Rayassss/Homework/README.md

## 睿睿的课设

***

### 编译代码

#### 编译ESP8266源码：

+ 在ubuntu系统下进入esp8266程序目录
+ 输入:：sudo chmod +x compile.sh requirements.sh
+ 输入：./requirements.sh 即可安装集成开发环境
+ 安装完成后，输入./compile即可编译

#### 编译STM32源码：
+ 安装keil for arm
+ 安装stm32f1xx.pack
+ 点击“编译”即可

#### 编译串口上位机：
+ 安装visual studio community 2017
+ 安装visual C#依赖
+ 点击“启动”即可编译

#### 编译网络上位机：
+ 安装python3.8.2
+ 安装配套的pip
+ 运行目录下的"build.bat"文件即可

#### 配置服务器端：
+ 将install.sh文件拷贝到服务器上
+ 输入：sudo chmod +x install.sh
+ 输入：./install.sh即可完成安装# Homework
