Rayassss/Homework/3119006261罗启睿的嵌入式课设计报告.md

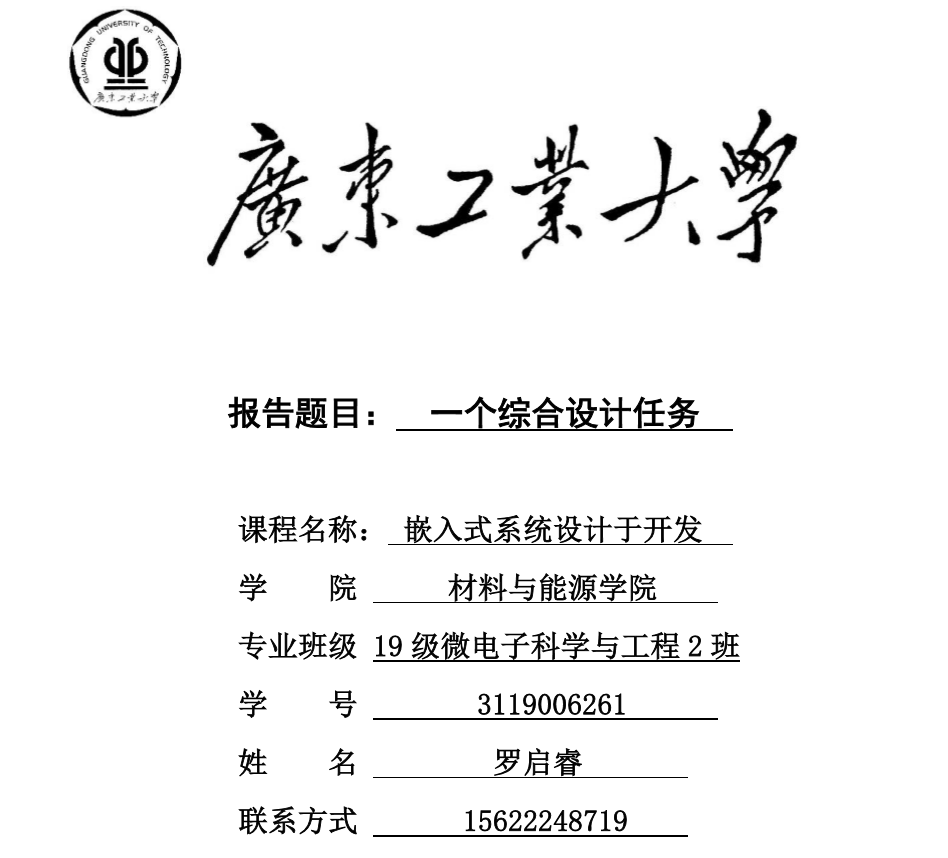
[picture p1: Related Pic/模板.png]


[toc]

# 一个综合的设计任务

## 任务目的

1.设计一个温湿度检测系统，同时使用STM32芯片的内部温度传感器和外部的DHT11温湿度传感器对环境参数进行监控；

2.将所读到的数据可以用使用串口助手进行检测，在PC上进行显示并绘制曲线；

3.将温湿度数据显示到TFT-LCD上并绘制出近60次采集的温湿度值曲线；

4.系统完成传感器数据的读取和显示后，即进入低功耗模式（睡眠模式）。同时每一分钟唤醒一次，并对传感器数据进行下一次测量和显示；

5。额外任务：将温湿度数据通过WIFI发送到服务器上，并且可以多设备订阅温湿度数据。

## 任务分析

### 硬件电路

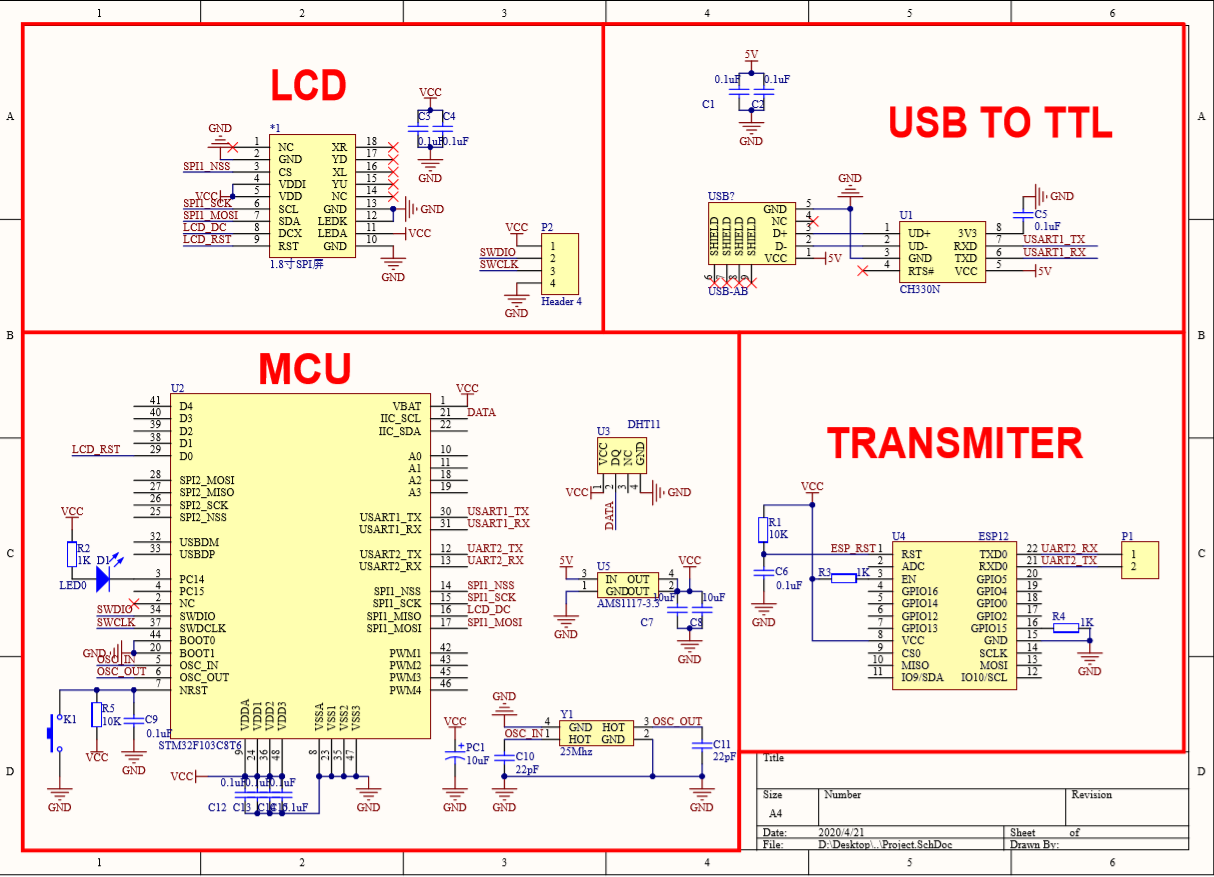
[picture p2: Related Pic/Sch.png]


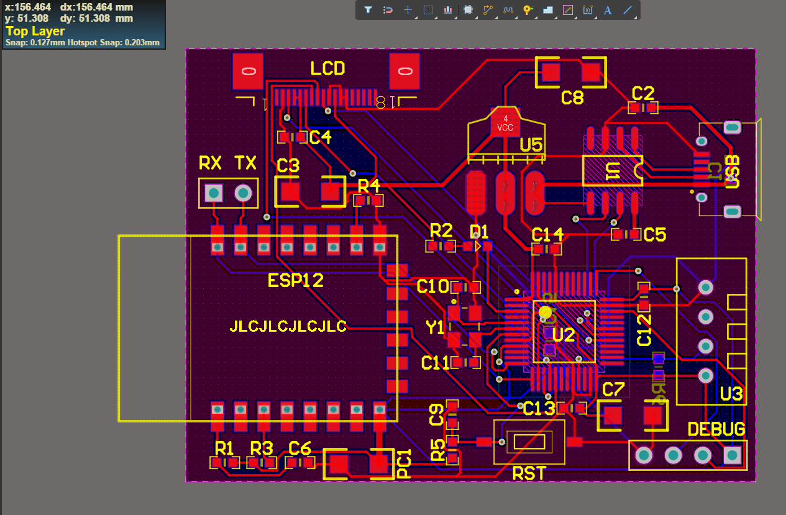
[picture p3: Related Pic/Pcb.png]


#### MCU

- 使用STM32F103C8T6芯片，其采用了ARM Cortex-M3微架构，是三级流水线按序单发射结构。CPU最高速度达72 MHz。
- 封装了64KB Flash以及20KB SRAM，含有IIC SPI USB CAN ADC GPIO TIM USART等多种常用外设，能满足开发需求。
- 性能强劲，算力可达1.25DMIPS/MHz。
- 用SWD口进行调试和下载程序，可以定位到断点，更加方便。
- 待机模式下电流仅425uA，功耗极低，很适合物联网产品的设计。

#### ESP8266

- ESP8266EX 集成了 32 位 Tensilica 处理器、标准数字外设接口、天线开关、射频 balun、功率放大器、低噪放大器、过滤器和电源管理模块等，仅需很少的外围电路，可将所占 PCB 空间降低。
- ESP8266EX 的工作温度范围大，且能够保持稳定的性能，能适应各种操作环境。
- ESP8266EX 专为移动设备、可穿戴电子产品和物联网应用而设计，通过多项专有技术实现了超低功耗。ESP8266EX 具有的省电模式适用于各种低功耗应用场景。
- ESP8266EX 内置超低功耗 Tensilica L106 32 位 RISC 处理器，CPU 时钟速度最高可达 160 MHz，支持实时操作系统 (RTOS) 和 Wi-Fi 协议栈，可将高达 80% 的处理能力留给应用编程和开发。

#### USB-TTL

- 采用CH330N串口转USB芯片，电脑端无需提供DB9、DB25等传统串口接口，只需要提供普通USB 2.0或以上的接口即可完成。
- 内置IRC，无需外部晶振提供时钟，简化了电路设计。
- 封装为SOP-8，体积更小，使电路板集成度更高。

#### LCD

- 采用了1.8寸的TFT-LCD彩屏，通过模拟SPI总线通信。
- 屏幕大小为128*144像素，显示格式为RGB565
- 提供了背光控制引脚，低功耗模式下可关闭背光以降低功耗
- 采用FPC0.5-18P接口，密度高体积小

#### DHT11

- 常见的温湿度传感器，仅用一根**DATA**总线便可完成数据的传输
- 出厂即校准温湿度值，无需用户收到货后再进行标定
- 其精度湿度+-5%RH， 温度+-2℃，湿度量程20-90%RH， 温度量程0~50℃。

#### 时钟树

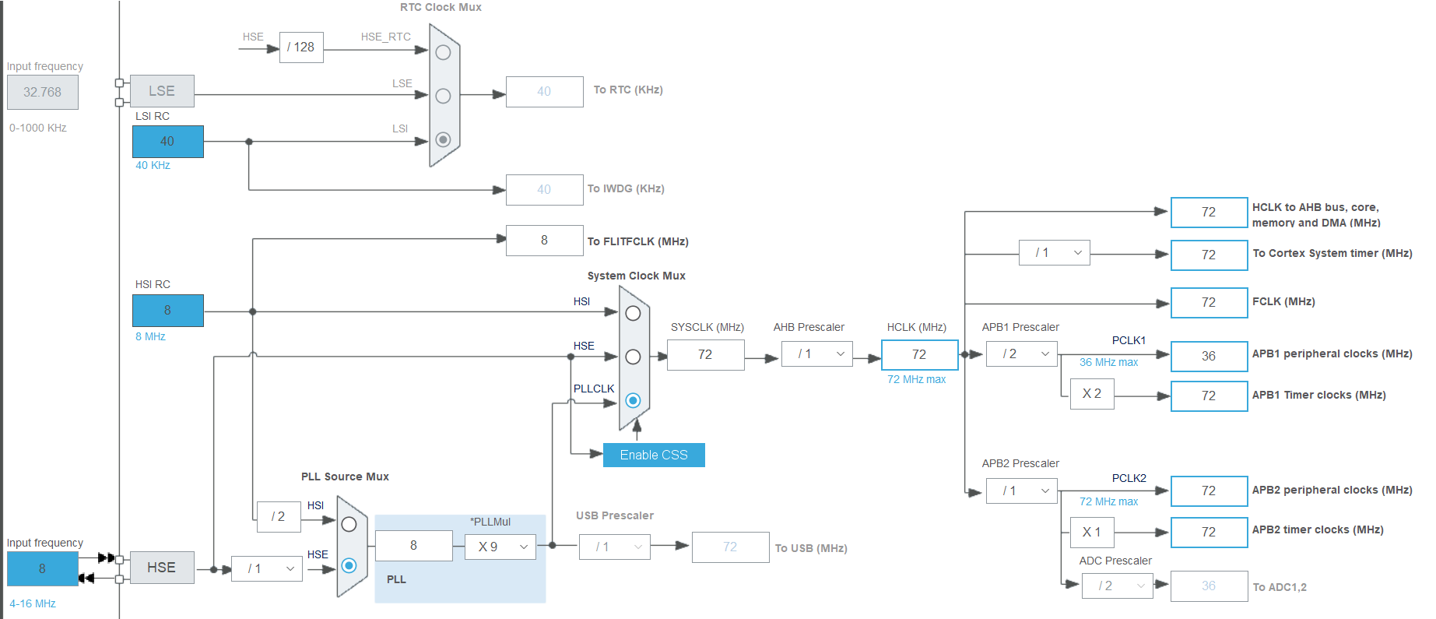
[picture p4: Related Pic/时钟树.png]
时钟树


#### 电源树

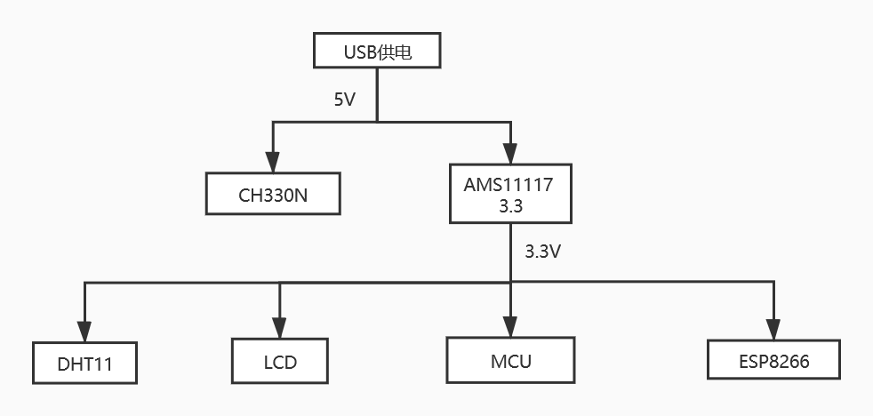
[picture p5: Related Pic/电源树.jpg]
电源树


### 程序

#### 物理层协议

- UART

  - STM32先与CH330通信，CH330采用串口协议与PC通信，用串口1烧录程序，打印动态曲线到串口助手上进行显示
- SPI
- 全双工通信，速度高传输稳定。分频后可以达到4Mbps的传输速率，是LCD显示屏流畅显示的关键与基础。
- One wire
- TCP
  - 点对点的通信协议，全双工模式，在这里用于ESP8266与我的阿里云服务器的连接，服务器不会出现断电、自动断开连接等情况，工作稳定，便于数据收集和处理。
- MQTT
  - MQTT（Message Queuing Telemetry Transport，消息队列遥测传输协议），是一种基于发布/订阅（publish/subscribe）模式的"轻量级"通讯协议，该协议构建于TCP/IP协议上。
  - MQTT是一个基于客户端-服务器的消息发布/订阅传输协议
  - 考虑到TCP协议只能支持点对点的工作方式，而在智能家居的大背景下，显然会不只一个用户会订阅家居反馈的消息，这便有了MQTT的使用价值，基于服务器和多台移动设备的连接，用户可自由选择是否订阅服务器的数据而不会与TCP协议一样不订阅数据就会报错等缺陷

#### 传输层协议（GDTP协议）
在物理层协议之上，用于在STM32与电脑端之间进行数据的传输。这是一个固定长度的传输协议，每个包（数据传输最小单位）的长度均为12字节，每个包的有效数据长度均为8字节（即一个包最多装载8字节的数据）。基本的包元素含有起始帧，包标识符，结束帧。通信时直接将数据包发出，无需进行握手等操作，每帧数据占用一字节（八个二进制位）。

***

##### 包内容：

PID Frame

###### 帧说明:
+ 帧头：值为0xff的帧

+ 桢尾：值为0xff的帧

+ 包标识符：占用四个位，该值可取0到15，低四位与高四位位反。

  自我校验方式在以下图中说明
  PID Frame

+ 调整帧：调整数据区以确保数据帧中不含有0xff。如果含有，就会设置相对应的位用于调整帧节，最后清除该数据帧为0x00

  调整方式在下图中说明
 Adjust Frame

#### 功能

##### 温湿度检测

- 根据时序图初始化DHT11，首先主机至少拉低总线18ms，后恢复拉高总线20-40us等待从机的80us左右的低电平响应，若检验到连接成功的信号则总线拉高准备接受数据
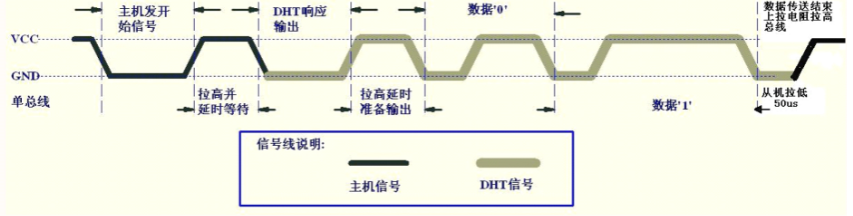
[picture p6: Related Pic/DHT11-1.png]
- 

##### 在LCD上动态绘制温湿度曲线

- 在程序中共有三条不同颜色的动态曲线，温度，湿度，单片机内部温度，其中每条曲线共有64个节点用于描绘图形，每个节点之间使用pNext指针相连。

- 用了单向链表来实现数据的储存。当每条曲线的数据量超过64个时，新增节点与删除旧节点的时间复杂度都为O(1)，使得更新数据的效率大大提高，曲线相应更加平滑。

- 这里对其中两个重要函数进行分析，其他的则显而易见了

  ```c
  void Free_Node(Curve_List_Node_t *NodeNum)  //释放节点
  {
  	NodeNum->Content = 0xFFFFFFFFUL;
  	NodeNum->pNext = (unsigned int *)0xFFFFFFFF;
  }
  Curve_List_Node_t *Malloc_Node(void)       //申请节点
  {
  	unsigned int counter;
  	for(counter = 0 ; counter < Node_Length * List_Num ; counter++)
  	{
  		if( FreeNode[counter].Content == 0xFFFFFFFFUL )
  			return &FreeNode[counter];
  	}
  	return 0x00000000UL;
  }
  ```

  如图，当每条曲线的数据量多于64个时，为了更新数据，需要释放第一个数据的空间，在这里将其标记为0xFFFFFFFFUL，原因是温度或者地址的值不可能达到全满的状态；而第二个标记空节点的函数在for循环中扫描到刚刚被释放的空间，也就是检测其值或其地址为0xFFFFFFFFUL时，可以通过返回值告诉List_Append将数据更新到链表中，再调用画线函数将链表绘制到显示屏上，完成数据的迭代。

##### 实时操作系统FreeROTS

- 考虑到本次项目需要完成数据的采集，数据与PC的传输，数据与LCD的传输，数据与ESP8266的传输，而每次传输的时间和周期难以敲定，不能简单地用main函数按序执行的方式实现，而若大量使用TIM中断程序，其中由于某些任务申请了大量局部变量，在中断函数中处理容易导致堆栈溢出和中断嵌套等现象，最终决定使用实时操作系统FreeROTS来完成任务的调度
- 实时操作系统与一般的操作系统相比，最大的特色就是“实时性”，如果有一个任务需要执行，实时操作系统会马上（在较短时间内）执行该任务，不会有较长的延时。这种特性保证了每个程序按照自身的不同频率运行且程序之间相互配合有序井然。

##### 低功耗模式

- 采用睡眠模式，每一分钟唤醒一次，结合了FreeROTS中的TickLess模式，每次进入低功耗时，所有外设的时钟关闭，达到真正的“低功耗”，当每次唤醒后，由FreeROTS调度任务，唤醒DHT11收集数据完成一次完整的项目任务。

##### 联网订阅

- MCU通过串口2将数据发送到ESP8266，此时ESP再通过微信的airkiss协议完成与WiFi的配网，再通过TCP协议发送到我的阿里云服务器，解决了TCP的点对点和需要实时订阅的问题
- 基于TCP的协议在使用MQTT协议，实现了一对多、多对一的推送/订阅的功能，同时解决了订阅设备与推送设备上线时间不同步的情况。
