Rayassss/Homework/Related Pic/DHT11-2.png

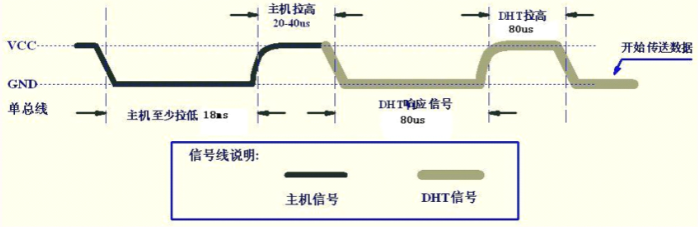
Related Pic/DHT11-2.png
