Rayassss/Homework/Circuit/Project.pdf

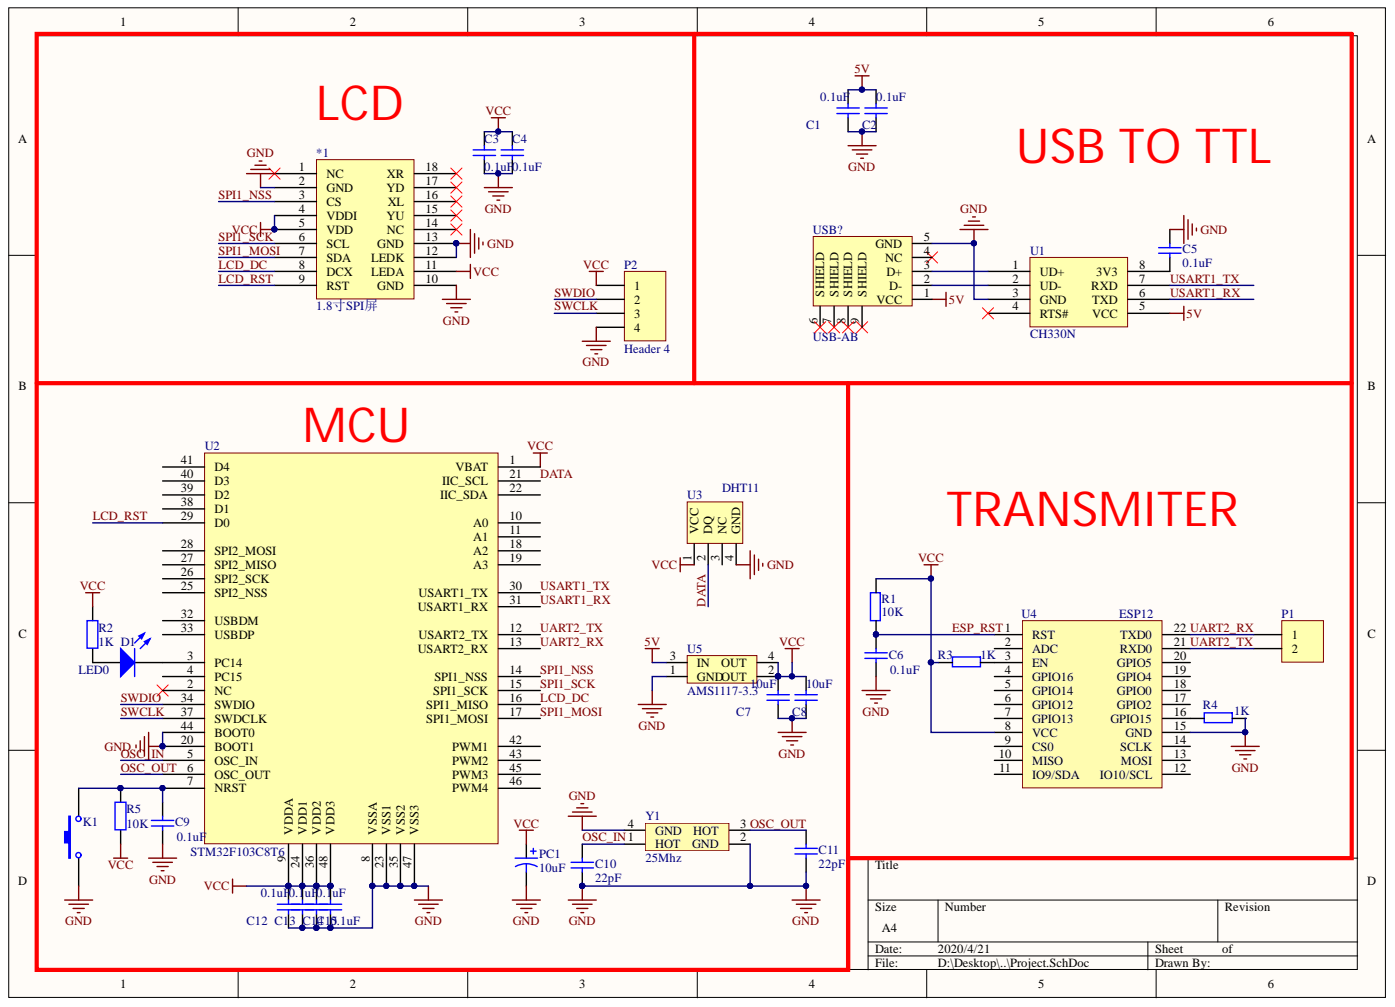
[picture p8: page 1]
