Rayassss/Homework/(list of files, drawings)

Other design files:
Circuit/MCU_Test.PcbLib
Circuit/PCB_Project.PrjPcb
Circuit/Project.PcbDoc
Circuit/Project.SchDoc
