Rayassss/Homework/ESP8266_Program/main/airkiss.c

#include <string.h>
#include <stdlib.h>
#include "freertos/FreeRTOS.h"
#include "freertos/task.h"
#include "freertos/event_groups.h"
#include "esp_wifi.h"
#include "esp_event.h"
#include "esp_log.h"
#include "esp_system.h"
#include "nvs_flash.h"
#include "tcpip_adapter.h"
#include "esp_smartconfig.h"
#include "smartconfig_ack.h"
#include "include/usr_spiffs.h"
#include <stdio.h>
#include "include/airkiss.h"

static EventGroupHandle_t wifi_event_group;
static const int CONNECTED_BIT = BIT0;
static const int ESPTOUCH_DONE_BIT = BIT1;
static const char *TAG = "sc";
static char wifi_conf[64];

void smartconfig_example_task(void * parm);

static void on_wifi_disconnect(void *arg, esp_event_base_t event_base,
                               int32_t event_id, void *event_data)
{
    system_event_sta_disconnected_t *event = (system_event_sta_disconnected_t *)event_data;

    ESP_LOGI(TAG, "Wi-Fi disconnected, trying to reconnect...");
    if (event->reason == WIFI_REASON_BASIC_RATE_NOT_SUPPORT) {
        esp_wifi_set_protocol(ESP_IF_WIFI_STA, WIFI_PROTOCAL_11B | WIFI_PROTOCAL_11G | WIFI_PROTOCAL_11N);
    }
    ESP_ERROR_CHECK(esp_wifi_connect());
}

static void on_got_ip(void *arg, esp_event_base_t event_base,
                      int32_t event_id, void *event_data)
{
    xEventGroupSetBits(wifi_event_group, CONNECTED_BIT);
}

static void initialise_wifi(void)
{
    tcpip_adapter_init();
    wifi_event_group = xEventGroupCreate();
    ESP_ERROR_CHECK(esp_event_loop_create_default());
    wifi_init_config_t cfg = WIFI_INIT_CONFIG_DEFAULT();
    ESP_ERROR_CHECK( esp_wifi_init(&cfg) );
    ESP_ERROR_CHECK(esp_event_handler_register(WIFI_EVENT, WIFI_EVENT_STA_DISCONNECTED, &on_wifi_disconnect, NULL));
    ESP_ERROR_CHECK(esp_event_handler_register(IP_EVENT, IP_EVENT_STA_GOT_IP, &on_got_ip, NULL));
    ESP_ERROR_CHECK( esp_wifi_set_mode(WIFI_MODE_STA) );
    ESP_ERROR_CHECK( esp_wifi_start() );
    ESP_ERROR_CHECK( esp_wifi_connect() );
}

static void sc_callback(smartconfig_status_t status, void *pdata)
{
    switch (status) {
        case SC_STATUS_WAIT:
            ESP_LOGI(TAG, "SC_STATUS_WAIT");
            break;
        case SC_STATUS_FIND_CHANNEL:
            ESP_LOGI(TAG, "SC_STATUS_FINDING_CHANNEL");
            break;
        case SC_STATUS_GETTING_SSID_PSWD:
            ESP_LOGI(TAG, "SC_STATUS_GETTING_SSID_PSWD");
            break;
        case SC_STATUS_LINK:
            ESP_LOGI(TAG, "SC_STATUS_LINK");
            wifi_config_t *wifi_config = pdata;
            ESP_LOGI(TAG, "SSID:%s", wifi_config->sta.ssid);
            ESP_LOGI(TAG, "PASSWORD:%s", wifi_config->sta.password);
            ESP_ERROR_CHECK( esp_wifi_disconnect() );
            ESP_ERROR_CHECK( esp_wifi_set_config(ESP_IF_WIFI_STA, wifi_config) );
            ESP_ERROR_CHECK( esp_wifi_connect() );
            sprintf(wifi_conf,"%s`%s\n",wifi_config->sta.ssid,wifi_config->sta.password);
            break;
        case SC_STATUS_LINK_OVER:
            ESP_LOGI(TAG, "SC_STATUS_LINK_OVER");
            if (pdata != NULL) {
                sc_callback_data_t *sc_callback_data = (sc_callback_data_t *)pdata;
                switch (sc_callback_data->type) {
                    case SC_ACK_TYPE_AIRKISS:
                        ESP_LOGI(TAG, "TYPE: AIRKISS");
                        break;
                    default:
                        ESP_LOGE(TAG, "TYPE: ERROR");
                        break;
                }
            }
            xEventGroupSetBits(wifi_event_group, ESPTOUCH_DONE_BIT);
            break;
        default:
            break;
    }
}

void smartconfig_example_task(void * parm)
{
    EventBits_t uxBits;
    ESP_ERROR_CHECK( esp_smartconfig_set_type(SC_TYPE_AIRKISS) );
    ESP_ERROR_CHECK( esp_smartconfig_start(sc_callback) );
    while (1) {
        uxBits = xEventGroupWaitBits(wifi_event_group, CONNECTED_BIT | ESPTOUCH_DONE_BIT, true, false, portMAX_DELAY); 
        if(uxBits & CONNECTED_BIT) {
            ESP_LOGI(TAG, "WiFi Connected to ap");
        }
        if(uxBits & ESPTOUCH_DONE_BIT) {
        	write_wifi_config(wifi_conf);
            ESP_LOGI(TAG, "smartconfig over");
            esp_smartconfig_stop();
            esp_restart();
            vTaskDelete(NULL);
        }
    }
}
unsigned char check_config(void)
{
	if(check_wifi_config() == EXISTED){
		ESP_LOGI(TAG,"File Existed!");
		return CONFIGURED;
	}
	else{
		ESP_LOGI(TAG,"File Non-Existed!");
		return NO_CONFIGURED;
	}
	
}
void airkiss_config(void)
{
    ESP_ERROR_CHECK( nvs_flash_init() );
    initialise_wifi();
    assert(xTaskCreate(smartconfig_example_task, "smartconfig_example_task", 4096, NULL, 3, NULL) == pdPASS);
}
