Rayassss/Homework/ESP8266_Program/main/mqtt.c

#include <stdio.h>
#include <stdint.h>
#include <stddef.h>
#include <string.h>

#include "freertos/FreeRTOS.h"
#include "freertos/task.h"
#include "esp_system.h"
#include "esp_log.h"
#include "esp_netif.h"
#include "esp_event.h"
#include "nvs.h"
#include "nvs_flash.h"

#include "lwip/sockets.h"
#include "lwip/dns.h"
#include "lwip/netdb.h"

#include "mqtt_client.h"

static const char *TAG = "MQTT";
static esp_mqtt_client_handle_t client;
void Publish_MQTT(const char *topic,char *content)
{
	esp_mqtt_client_publish(client, topic, content, 0, 1, 0);
}
esp_err_t mqtt_event_handler(esp_mqtt_event_handle_t event)
{
	client = event->client;
    // your_context_t *context = event->context;
    switch (event->event_id) {
        case MQTT_EVENT_CONNECTED:
            ESP_LOGI(TAG, "MQTT_EVENT_CONNECTED");
//            esp_mqtt_client_publish(client, "humi", "hello!!", 0, 1, 0);
//            ESP_LOGI(TAG, "sent publish successful, msg_id=%d", msg_id);

//            esp_mqtt_client_subscribe(client, "rcv", 0);
//            ESP_LOGI(TAG, "sent subscribe successful, msg_id=%d", msg_id);

//            msg_id = esp_mqtt_client_unsubscribe(client, "/topic/qos1");
//            ESP_LOGI(TAG, "sent unsubscribe successful, msg_id=%d", msg_id);
            break;
        case MQTT_EVENT_DISCONNECTED:
            ESP_LOGI(TAG, "MQTT_EVENT_DISCONNECTED");
            break;

        case MQTT_EVENT_SUBSCRIBED:
            ESP_LOGI(TAG, "MQTT_EVENT_SUBSCRIBED, msg_id=%d", event->msg_id);
//            msg_id = esp_mqtt_client_publish(client, "/topic/qos0", "data", 0, 0, 0);
//            ESP_LOGI(TAG, "sent publish successful, msg_id=%d", msg_id);
            break;
        case MQTT_EVENT_UNSUBSCRIBED:
            ESP_LOGI(TAG, "MQTT_EVENT_UNSUBSCRIBED, msg_id=%d", event->msg_id);
            break;
        case MQTT_EVENT_PUBLISHED:
            ESP_LOGI(TAG, "MQTT_EVENT_PUBLISHED, msg_id=%d", event->msg_id);
            break;
        case MQTT_EVENT_DATA:
            ESP_LOGI(TAG, "MQTT_EVENT_DATA");
            printf("TOPIC=%.*s\r\n", event->topic_len, event->topic);
            printf("DATA=%.*s\r\n", event->data_len, event->data);
            break;
        case MQTT_EVENT_ERROR:
            ESP_LOGI(TAG, "MQTT_EVENT_ERROR");
            break;
    }
    return ESP_OK;
}

void mqtt_start(void)
{
    esp_mqtt_client_config_t mqtt_cfg = {
        .uri = "mqtt://47.93.184.19",
        .event_handle = mqtt_event_handler,
        // .user_context = (void *)your_context
    };

#if CONFIG_BROKER_URL_FROM_STDIN
    char line[128];

    if (strcmp(mqtt_cfg.uri, "FROM_STDIN") == 0) {
        int count = 0;
        printf("Please enter url of mqtt broker\n");
        while (count < 128) {
            int c = fgetc(stdin);
            if (c == '\n') {
                line[count] = '\0';
                break;
            } else if (c > 0 && c < 127) {
                line[count] = c;
                ++count;
            }
            vTaskDelay(10 / portTICK_PERIOD_MS);
        }
        mqtt_cfg.uri = line;
        printf("Broker url: %s\n", line);
    } else {
        ESP_LOGE(TAG, "Configuration mismatch: wrong broker url");
        abort();
    }
#endif /* CONFIG_BROKER_URL_FROM_STDIN */

    esp_mqtt_client_handle_t client = esp_mqtt_client_init(&mqtt_cfg);
    esp_mqtt_client_start(client);
}
