Rayassss/Homework/STM32_Program/Hadrware/Timer.c

#include "System_Config.h"
#include "Timer.h"
unsigned long Timer3_Counter=0;
void TIM3_IRQHandler()
{
	TIM_ClearITPendingBit(TIM3,TIM_IT_Update);
	Timer3_Counter++;
}
void Timer_Init(u16 Period)
{
	TIM_TimeBaseInitTypeDef TIM_TimeBaseInitStructure;
	NVIC_InitTypeDef NVIC_InitStructure;
	RCC_APB1PeriphClockCmd(RCC_APB1Periph_TIM3,ENABLE);
	TIM_ClearITPendingBit(TIM3,TIM_IT_Update);
	TIM_TimeBaseInitStructure.TIM_Period = Period;
	TIM_TimeBaseInitStructure.TIM_Prescaler = 3599;		// 36000000/3600 = 10kHz
	TIM_TimeBaseInitStructure.TIM_ClockDivision = 0;
	TIM_TimeBaseInitStructure.TIM_CounterMode = TIM_CounterMode_Up;
	TIM_TimeBaseInit(TIM3,&TIM_TimeBaseInitStructure);	
	TIM_Cmd(TIM3,ENABLE);
	TIM_ITConfig(TIM3,TIM_IT_Update,ENABLE);
	NVIC_InitStructure.NVIC_IRQChannel=TIM3_IRQn;
	NVIC_InitStructure.NVIC_IRQChannelPreemptionPriority = 2;
	NVIC_InitStructure.NVIC_IRQChannelSubPriority = 0;
	NVIC_InitStructure.NVIC_IRQChannelCmd = ENABLE;
	NVIC_Init(&NVIC_InitStructure);	
}
