Rayassss/Homework/STM32_Program/Hadrware/USART2.c

/**
  ******************************************************************************
  * @file    USART2.c
  * @author  Acme-LaoZhu
  * @version V1.0.0
  * @date    25-March-2019
  * @brief  This file is used to Config USART2 Periph
  * @License:GNU General Public License v3.0         
  ******************************************************************************
**/
#include "System_Config.h"
#include "USART2.h"
#include "Var.h"
void USART2_IRQHandler(void)
{
	if(USART_GetITStatus(USART2, USART_IT_RXNE) != RESET)
	{
		USART2_Receive(USART_ReceiveData(USART2));
		USART_ClearFlag(USART2, USART_IT_RXNE);
  }
}
__weak void USART2_Receive(unsigned char BUFFER)
{
	
}
void USART2_Init(unsigned long baud)
{
	GPIO_InitTypeDef GPIO_InitStructure;
	USART_InitTypeDef USART_InitStructure;
	NVIC_InitTypeDef NVIC_InitStructure;
	RCC_APB1PeriphClockCmd(RCC_APB1Periph_USART2, ENABLE);
  GPIO_InitStructure.GPIO_Pin = GPIO_Pin_2;
  GPIO_InitStructure.GPIO_Speed = GPIO_Speed_50MHz;
  GPIO_InitStructure.GPIO_Mode = GPIO_Mode_AF_PP;
  GPIO_Init(GPIOA, &GPIO_InitStructure);
  GPIO_InitStructure.GPIO_Pin = GPIO_Pin_3;
  GPIO_InitStructure.GPIO_Mode = GPIO_Mode_IN_FLOATING;
  GPIO_Init(GPIOA, &GPIO_InitStructure);
  NVIC_InitStructure.NVIC_IRQChannel = USART2_IRQn;
	NVIC_InitStructure.NVIC_IRQChannelPreemptionPriority=USART2_Priority;
	NVIC_InitStructure.NVIC_IRQChannelSubPriority = 0;
	NVIC_InitStructure.NVIC_IRQChannelCmd = ENABLE;
	NVIC_Init(&NVIC_InitStructure);
	USART_InitStructure.USART_BaudRate = baud;
	USART_InitStructure.USART_WordLength = USART_WordLength_8b;
	USART_InitStructure.USART_StopBits = USART_StopBits_1;
	USART_InitStructure.USART_Parity = USART_Parity_No;
	USART_InitStructure.USART_HardwareFlowControl = USART_HardwareFlowControl_None;
	USART_InitStructure.USART_Mode = USART_Mode_Rx | USART_Mode_Tx;
  USART_Init(USART2, &USART_InitStructure);
  USART_ITConfig(USART2, USART_IT_RXNE, ENABLE);
  USART_Cmd(USART2, ENABLE);
}
